Appletea404/Project7_HandCipher/Vitis/platform_HandCipher/microblaze_riscv_0/standalone_microblaze_riscv_0/bsp/libsrc/build_configs/gen_bsp/install_manifest.txt

/home/kwakyj91/workspace_ondevice_2/project/project_07/Project7_HandCipher/Vitis/platform_HandCipher/microblaze_riscv_0/standalone_microblaze_riscv_0/bsp/include/../include/xil_types.h
/home/kwakyj91/workspace_ondevice_2/project/project_07/Project7_HandCipher/Vitis/platform_HandCipher/microblaze_riscv_0/standalone_microblaze_riscv_0/bsp/include/../include/xil_util.h
/home/kwakyj91/workspace_ondevice_2/project/project_07/Project7_HandCipher/Vitis/platform_HandCipher/microblaze_riscv_0/standalone_microblaze_riscv_0/bsp/include/../include/xil_cryptoalginfo.h
/home/kwakyj91/workspace_ondevice_2/project/project_07/Project7_HandCipher/Vitis/platform_HandCipher/microblaze_riscv_0/standalone_microblaze_riscv_0/bsp/include/../include/xmicroblaze_riscv.h
/home/kwakyj91/workspace_ondevice_2/project/project_07/Project7_HandCipher/Vitis/platform_HandCipher/microblaze_riscv_0/standalone_microblaze_riscv_0/bsp/include/../include/xpseudo_asm_gcc.h
/home/kwakyj91/workspace_ondevice_2/project/project_07/Project7_HandCipher/Vitis/platform_HandCipher/microblaze_riscv_0/standalone_microblaze_riscv_0/bsp/include/../include/xmicroblaze_riscv_config.h
/home/kwakyj91/workspace_ondevice_2/project/project_07/Project7_HandCipher/Vitis/platform_HandCipher/microblaze_riscv_0/standalone_microblaze_riscv_0/bsp/include/../include/xil_io.h
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
/home/kwakyj91/workspace_ondevice_2/project/project_07/Project7_HandCipher/Vitis/platform_HandCipher/microblaze_riscv_0/standalone_microblaze_riscv_0/bsp/include/../include/xpseudo_asm.h
