Appletea404/Project7_HandCipher/troubleshooting/UART_debug_AXI.png

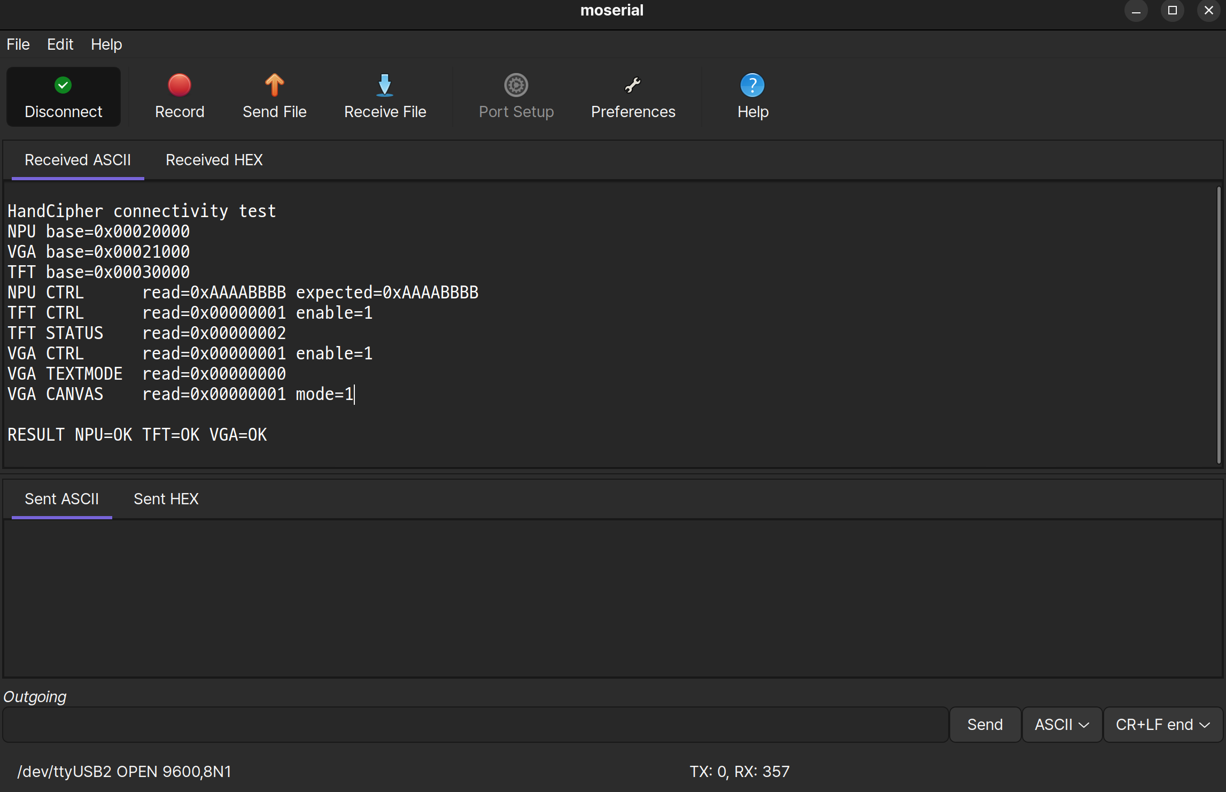
troubleshooting/UART_debug_AXI.png
