Appletea404/Project7_HandCipher/(commit log)

2026-06-27 Add weight memory file and troubleshooting documentation for touch screen noise issues
    - Added a new memory file `weights_l2.mem` for model weights.
    - Created `troubleshooting.md` to address touch screen noise issues during operation, detailing symptoms, causes, and multiple solutions including adjustments to SPI clock speed, sampling periods, and hardware configurations.
    [test_top.v, tft_lcd_sv.sv]
2026-06-30 Refactor code structure for improved readability and maintainability
    [cmake_lib_configs.txt]
2026-07-01 1차 완성본 인식률 떨어짐, 알파벳에 원하는 내용 저장 전
    [cmake_lib_configs.txt]
2026-07-01 Add HandCipher application for real-time character recognition and decryption
    - Implemented main functionality for a hand-drawn character decoder using a TFT LCD and VGA display.
    - Integrated GPIO for user input handling (buttons and switches) to control encryption/decryption modes and buffer management.
    - Added software-based EMNIST inference for character recognition.
    - Established functions for canvas management, including clearing and transferring pixel data between TFT and VGA.
    - Included custom delay function to manage timing for touch input processing.
    - Enhanced user experience with real-time feedback on the VGA display.
